DFlak/dingoPDM/DingoPDM/DingoPDM.kicad_pcb

## KiCad design DingoPDM/DingoPDM.kicad_pcb (2025-12-28)

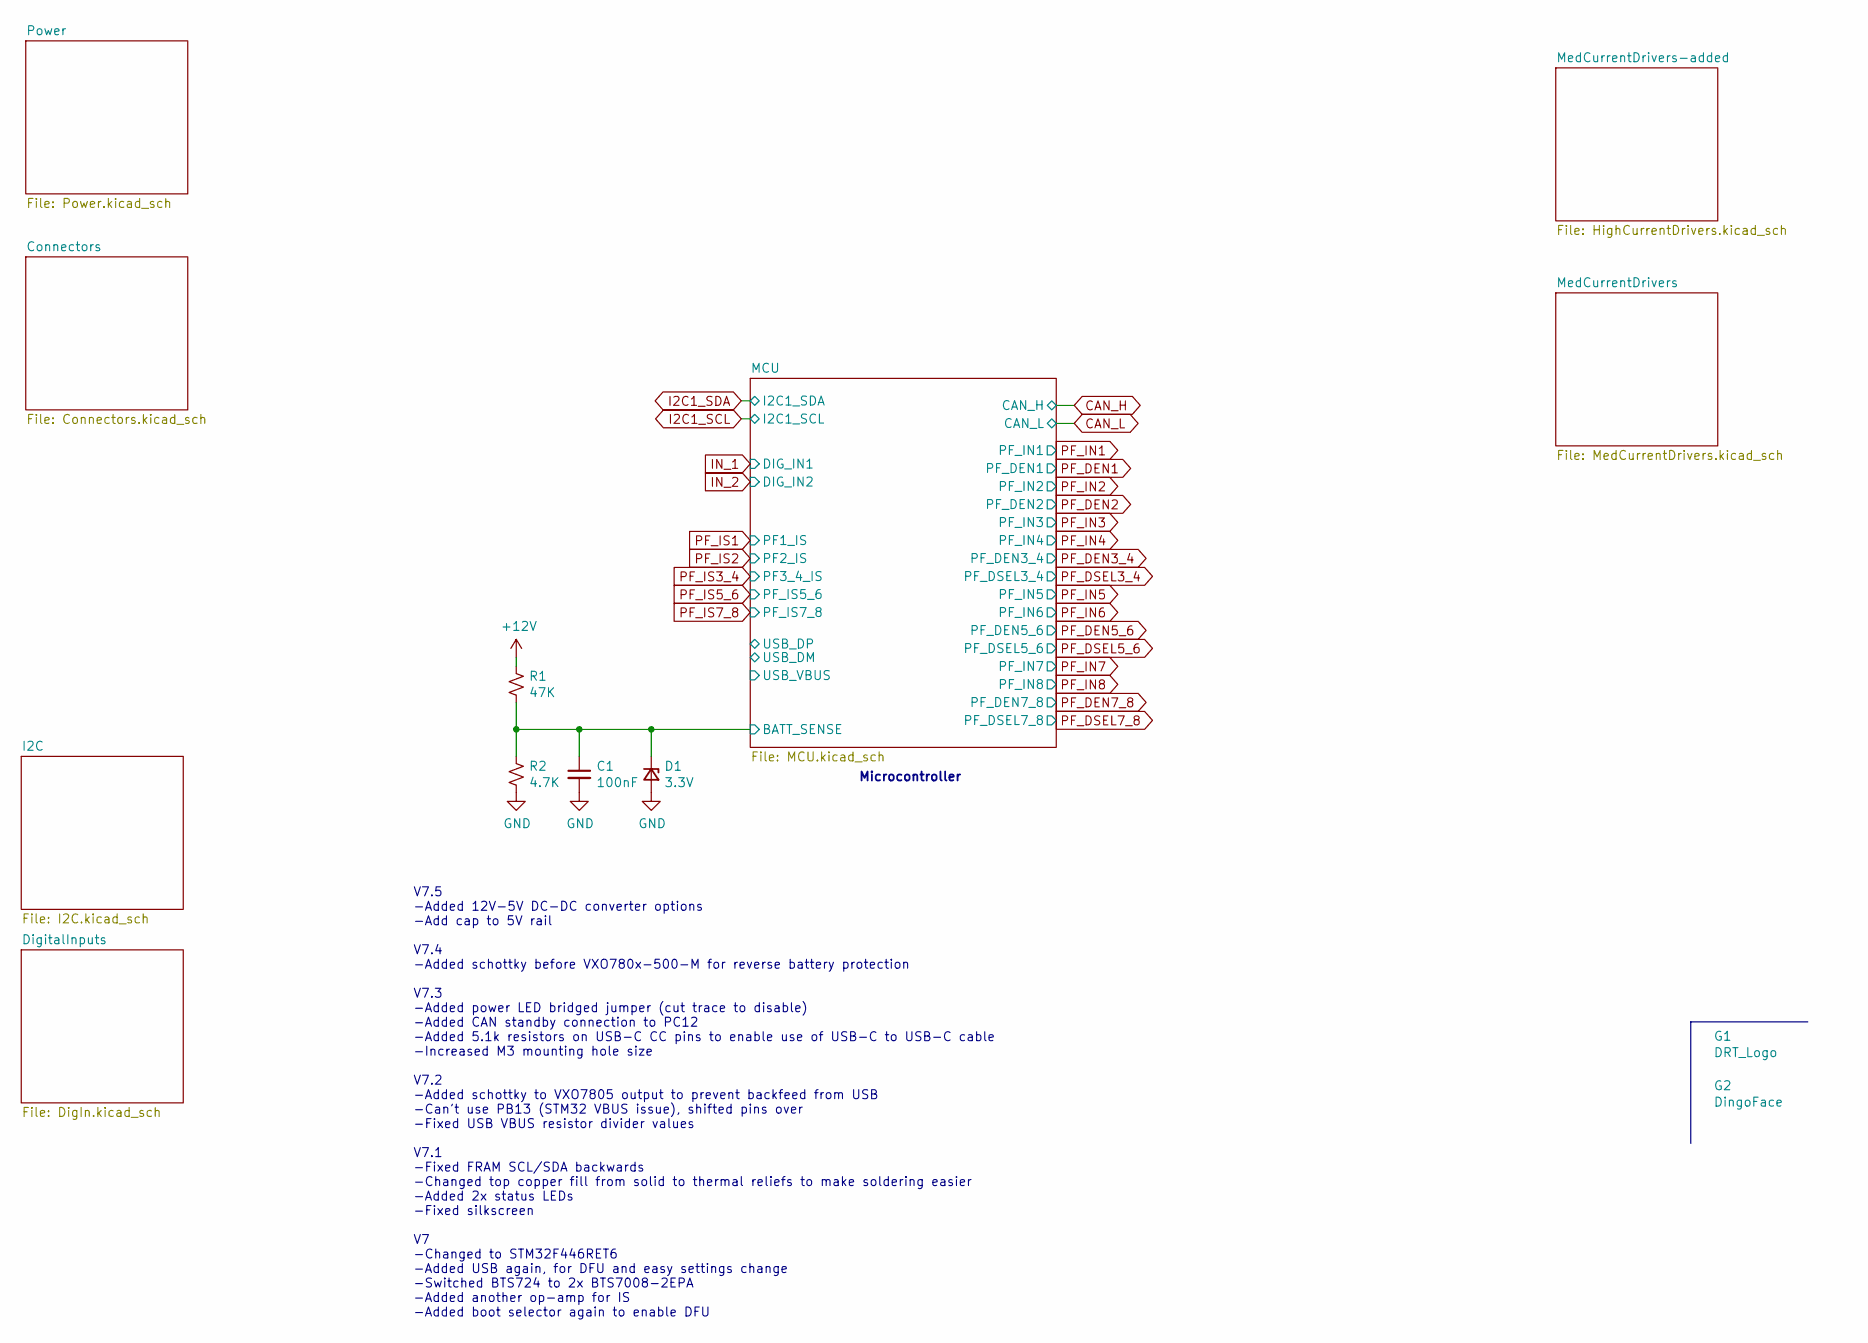
[picture p1: schematic DingoPDM.kicad_sch]

Parts:
C1: 100nF; C_0805_2012Metric; Digi-Key_PN 478-1395-1-ND
D1: 3.3V; D_SOD-323_HandSoldering; Digi-Key_PN 1727-5150-1-ND
G1: DRT_Logo; DRTLogo
G2: DingoFace; DingoFaceNoFill
R1: 47K; R_0805_2012Metric; Digi-Key_PN 311-47.0KCRCT-ND
R2: 4.7K; R_0805_2012Metric; Digi-Key_PN 311-4.70KCRCT-ND

Connections:
+12V: R1.1; also elsewhere on the board
/MCU/BATT_SENSE: C1.1, D1.1 (K), R1.2, R2.1; also elsewhere on the board
GND: C1.2, D1.2 (A), R2.2; also elsewhere on the board

Notes on the sheet:
Microcontroller
V7.5 -Added 12V-5V DC-DC converter options -Add cap to 5V rail V7.4 -Added schottky before VXO780x-500-M for reverse battery protection V7.3 -Added power LED bridged jumper (cut trace to disable) -Added CAN standby connection to PC12 -Added 5.1k resistors on USB-C CC pins to enable use of USB-C to 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

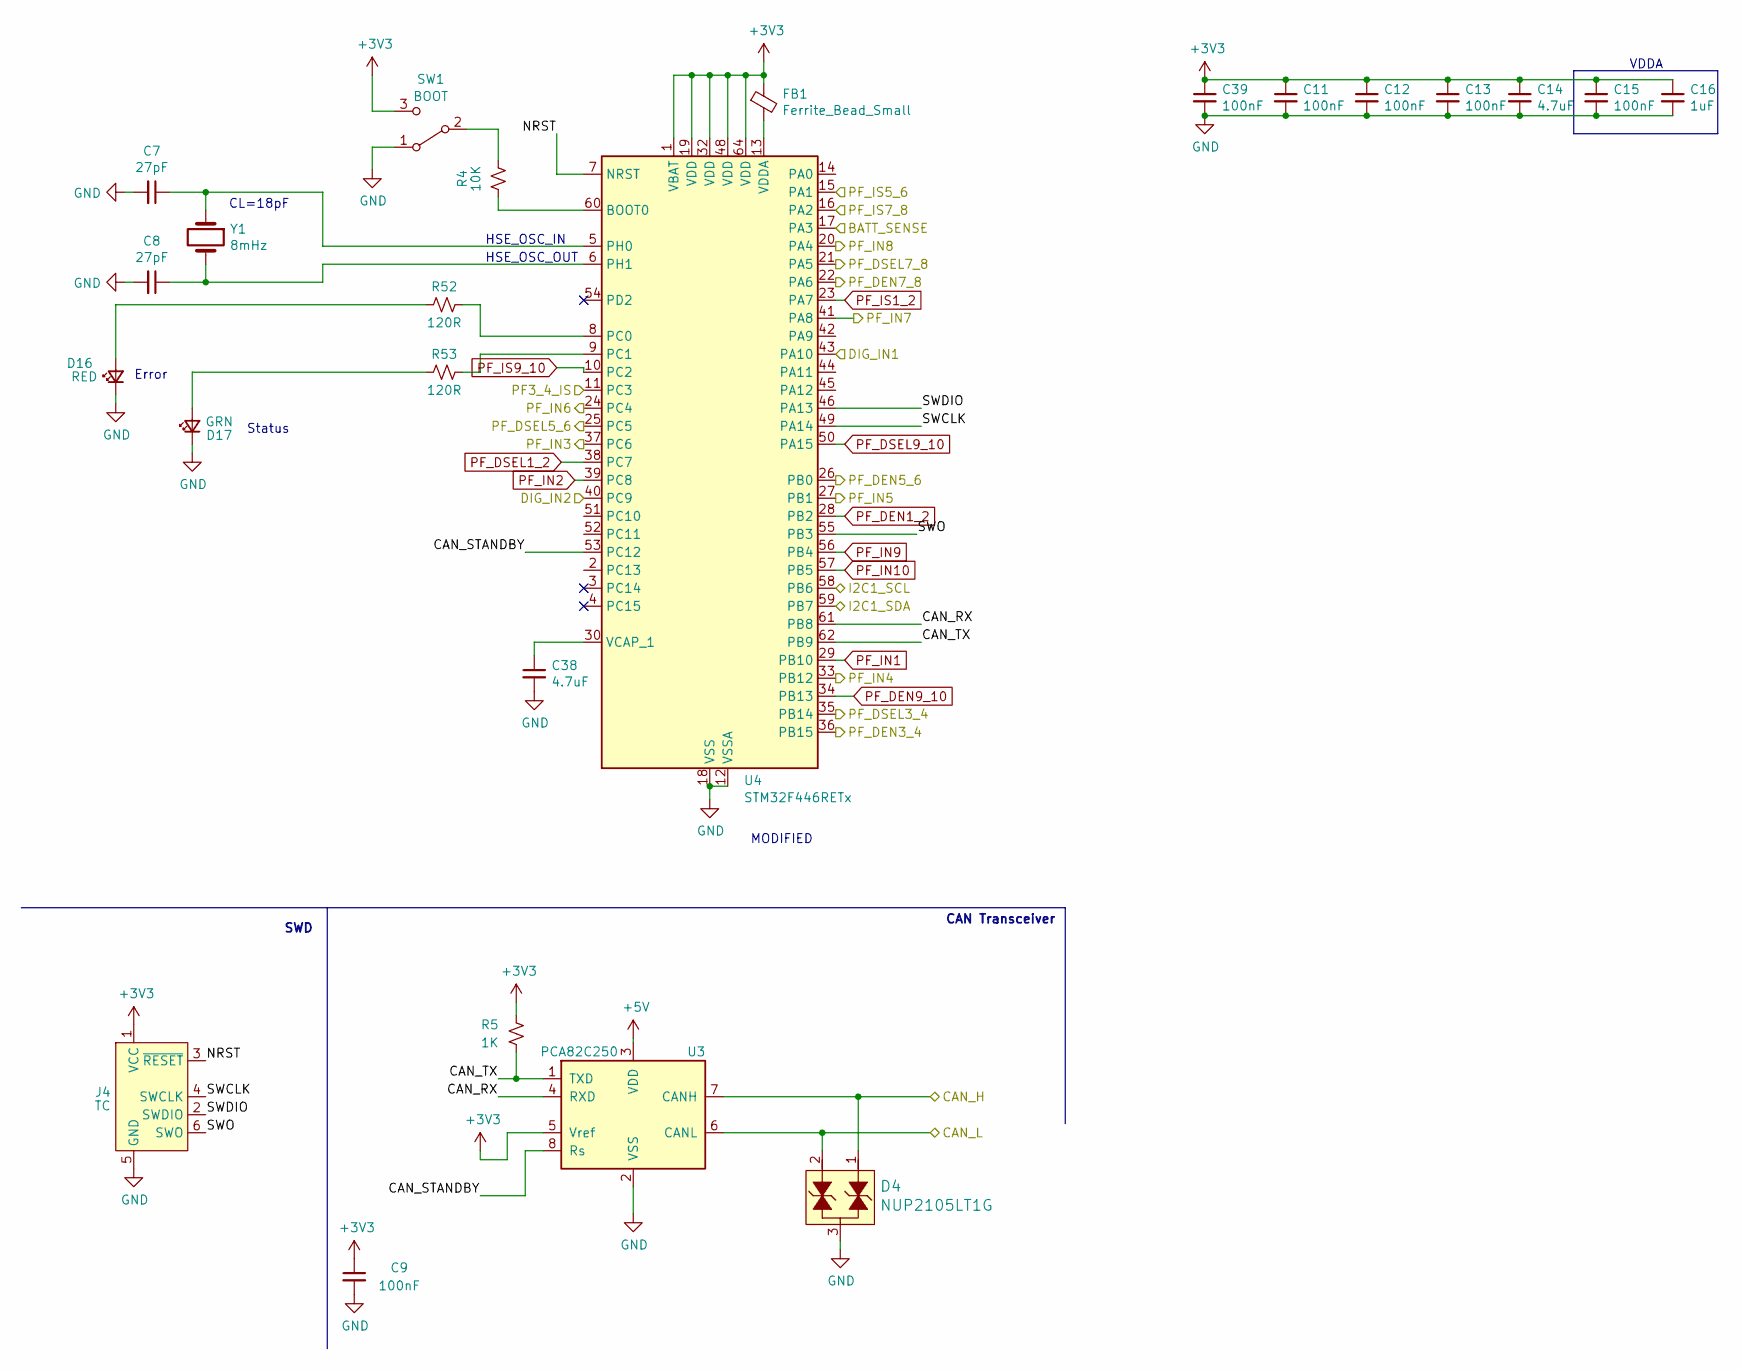
[picture p2: schematic MCU.kicad_sch, dingoPDM]

Parts:
C7, C8: 27pF; C_0805_2012Metric; Digi-Key_PN 478-10518-1-ND
C9, C11, C12, C13, C15, C39: 100nF; C_0805_2012Metric; Digi-Key_PN 478-1395-1-ND
C14, C38: 4.7uF; C_0805_2012Metric; Digi-Key_PN 1276-2873-1-ND
C16: 1uF; C_0805_2012Metric; Digi-Key_PN 311-1365-1-ND
D4: NUP2105LT1G; SOT-23-3; Digi-Key_PN NUP2105LT1GOSCT-ND
D16: RED; LED_0805_2012Metric; Digi-Key_PN 475-1278-1-ND
D17: GRN; LED_0805_2012Metric; Digi-Key_PN 475-1410-1-ND
FB1: Ferrite_Bead_Small; R_0805_2012Metric; Digi-Key_PN 490-1054-1-ND
J4: TC; Tag-Connect_TC2030-IDC-NL_2x03_P1.27mm_Vertical
R4: 10K; R_0805_2012Metric; Digi-Key_PN 311-10.0KCRDKR-ND
R5: 1K; R_0805_2012Metric; Digi-Key_PN 311-1.0KARCT-ND
R52, R53: 120R; R_0805_2012Metric; Digi-Key_PN 311-120CRCT-ND
SW1: BOOT; CJS-1200TB; Digi-Key_PN 563-CJS-1200TB1CT-ND
U3: PCA82C250; SOIC-8_3.9x4.9mm_P1.27mm; Digi-Key_PN 568-10316-1-ND
U4: STM32F446RETx; LQFP-64_10x10mm_P0.5mm; Digi-Key_PN 497-15376-ND
Y1: 8mHz; Crystal_SMD_5032-2Pin_5.0x3.2mm_HandSoldering; Digi-Key_PN 535-10630-1-ND

Connections:
+3V3: C9.1, C11.1, C12.1, C13.1, C14.1, C15.1, C16.1, C39.1, FB1.1, J4.1 (VCC), R5.2, SW1.3 (C), U3.5 (Vref), U4.1 (VBAT), U4.19 (VDD), U4.32 (VDD), U4.48 (VDD), U4.64 (VDD); also elsewhere on the board
+5V: U3.3 (VDD); also elsewhere on the board
/MCU/BATT_SENSE: U4.17 (PA3); also elsewhere on the board
/MCU/CAN_RX: U3.4 (RXD), U4.61 (PB8)
/MCU/CAN_STANDBY: U3.8 (Rs), U4.53 (PC12)
/MCU/CAN_TX: R5.1, U3.1 (TXD), U4.62 (PB9)
/MCU/NRST: J4.3 (~RESET), U4.7 (NRST)
/MCU/SWCLK: J4.4 (SWCLK), U4.49 (PA14)
/MCU/SWDIO: J4.2 (SWDIO), U4.46 (PA13)
/MCU/SWO: J4.6 (SWO), U4.55 (PB3)
CAN_H: D4.1, U3.7 (CANH); also elsewhere on the board
CAN_L: D4.2, U3.6 (CANL); also elsewhere on the board
GND: C7.2, C8.2, C9.2, C11.2, C12.2, C13.2, C14.2, C15.2, C16.2, C38.2, C39.2, D4.3, D16.1 (K), D17.1 (K), J4.5 (GND), SW1.1 (A), U3.2 (VSS), U4.12 (VSSA), U4.18 (VSS), U4.31 (VSS), U4.47 (VSS), U4.63 (VSS); also elsewhere on the board
I2C1_SCL: U4.58 (PB6); also elsewhere on the board
I2C1_SDA: U4.59 (PB7); also elsewhere on the board
IN_1: U4.43 (PA10); also elsewhere on the board
IN_2: U4.40 (PC9); also elsewhere on the board
unnamed: D16.2 (A), R52.2
unnamed: D17.2 (A), R53.2
unnamed: R4.1, SW1.2 (B)
unnamed: R4.2, U4.60 (BOOT0)
unnamed: R52.1, U4.8 (PC0)
unnamed: R53.1, U4.9 (PC1)
unnamed: C7.1, U4.5 (PH0), Y1.1
unnamed: C8.1, U4.6 (PH1), Y1.2
unnamed: C38.1, U4.30 (VCAP_1)
unnamed: FB1.2, U4.13 (VDDA)
PF_DEN1_2: U4.28 (PB2); also elsewhere on the board
PF_DEN3_4: U4.36 (PB15); also elsewhere on the board
PF_DEN5_6: U4.26 (PB0); also elsewhere on the board
PF_DEN7_8: U4.22 (PA6); also elsewhere on the board
PF_DEN9_10: U4.34 (PB13); also elsewhere on the board
PF_DSEL1_2: U4.38 (PC7); also elsewhere on the board
PF_DSEL3_4: U4.35 (PB14); also elsewhere on the board
PF_DSEL5_6: U4.25 (PC5); also elsewhere on the board
PF_DSEL7_8: U4.21 (PA5); also elsewhere on the board
PF_DSEL9_10: U4.50 (PA15); also elsewhere on the board
PF_IN1: U4.29 (PB10); also elsewhere on the board
PF_IN2: U4.39 (PC8); also elsewhere on the board
PF_IN3: U4.37 (PC6); also elsewhere on the board
PF_IN4: U4.33 (PB12); also elsewhere on the board
PF_IN5: U4.27 (PB1); also elsewhere on the board
PF_IN6: U4.24 (PC4); also elsewhere on the board
PF_IN7: U4.41 (PA8); also elsewhere on the board
PF_IN8: U4.20 (PA4); also elsewhere on the board
PF_IN9: U4.56 (PB4); also elsewhere on the board
PF_IN10: U4.57 (PB5); also elsewhere on the board
PF_IS1_2: U4.23 (PA7); also elsewhere on the board
PF_IS3_4: U4.11 (PC3); also elsewhere on the board
PF_IS5_6: U4.15 (PA1); also elsewhere on the board
PF_IS7_8: U4.16 (PA2); also elsewhere on the board
PF_IS9_10: U4.10 (PC2); also elsewhere on the board

Notes on the sheet:
SWD
Error
CAN Transceiver
HSE_OSC_IN
MODIFIED
CL=18pF
HSE_OSC_OUT
VDDA
Status

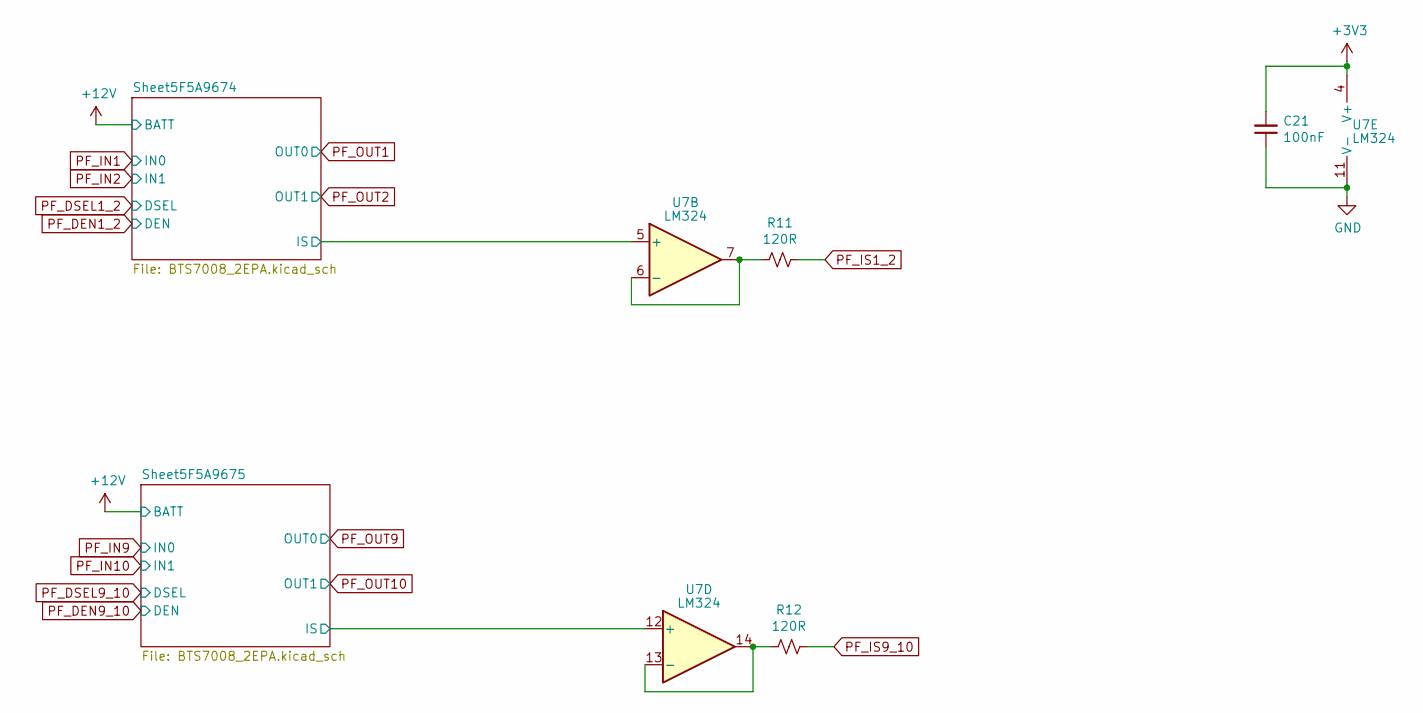
[picture p3: schematic HighCurrentDrivers.kicad_sch, dingoPDM]

Parts:
C21: 100nF; C_0805_2012Metric; Digi-Key_PN 478-1395-1-ND
R11, R12: 120R; R_0805_2012Metric; Digi-Key_PN 311-120CRCT-ND
U7: LM324; TSSOP-14_4.4x5mm_P0.65mm; Digi-Key_PN 497-7330-1-ND

Connections:
+3V3: C21.2, U7.4 (V+); also elsewhere on the board
/MedCurrentDrivers-added/Sheet5F5A9674/IS: U7.5 (+); also elsewhere on the board
/MedCurrentDrivers-added/Sheet5F5A9675/IS: U7.12 (+); also elsewhere on the board
/MedCurrentDrivers/Sheet5F5A9674/IS: U7.10 (+); also elsewhere on the board
GND: C21.1, U7.11 (V-); also elsewhere on the board
unnamed: R11.2, U7.6 (-), U7.7
unnamed 47: U7.8, U7.9 (-); also elsewhere on the board
unnamed: R12.2, U7.13 (-), U7.14
PF_IS1_2: R11.1; also elsewhere on the board
PF_IS9_10: R12.1; also elsewhere on the board

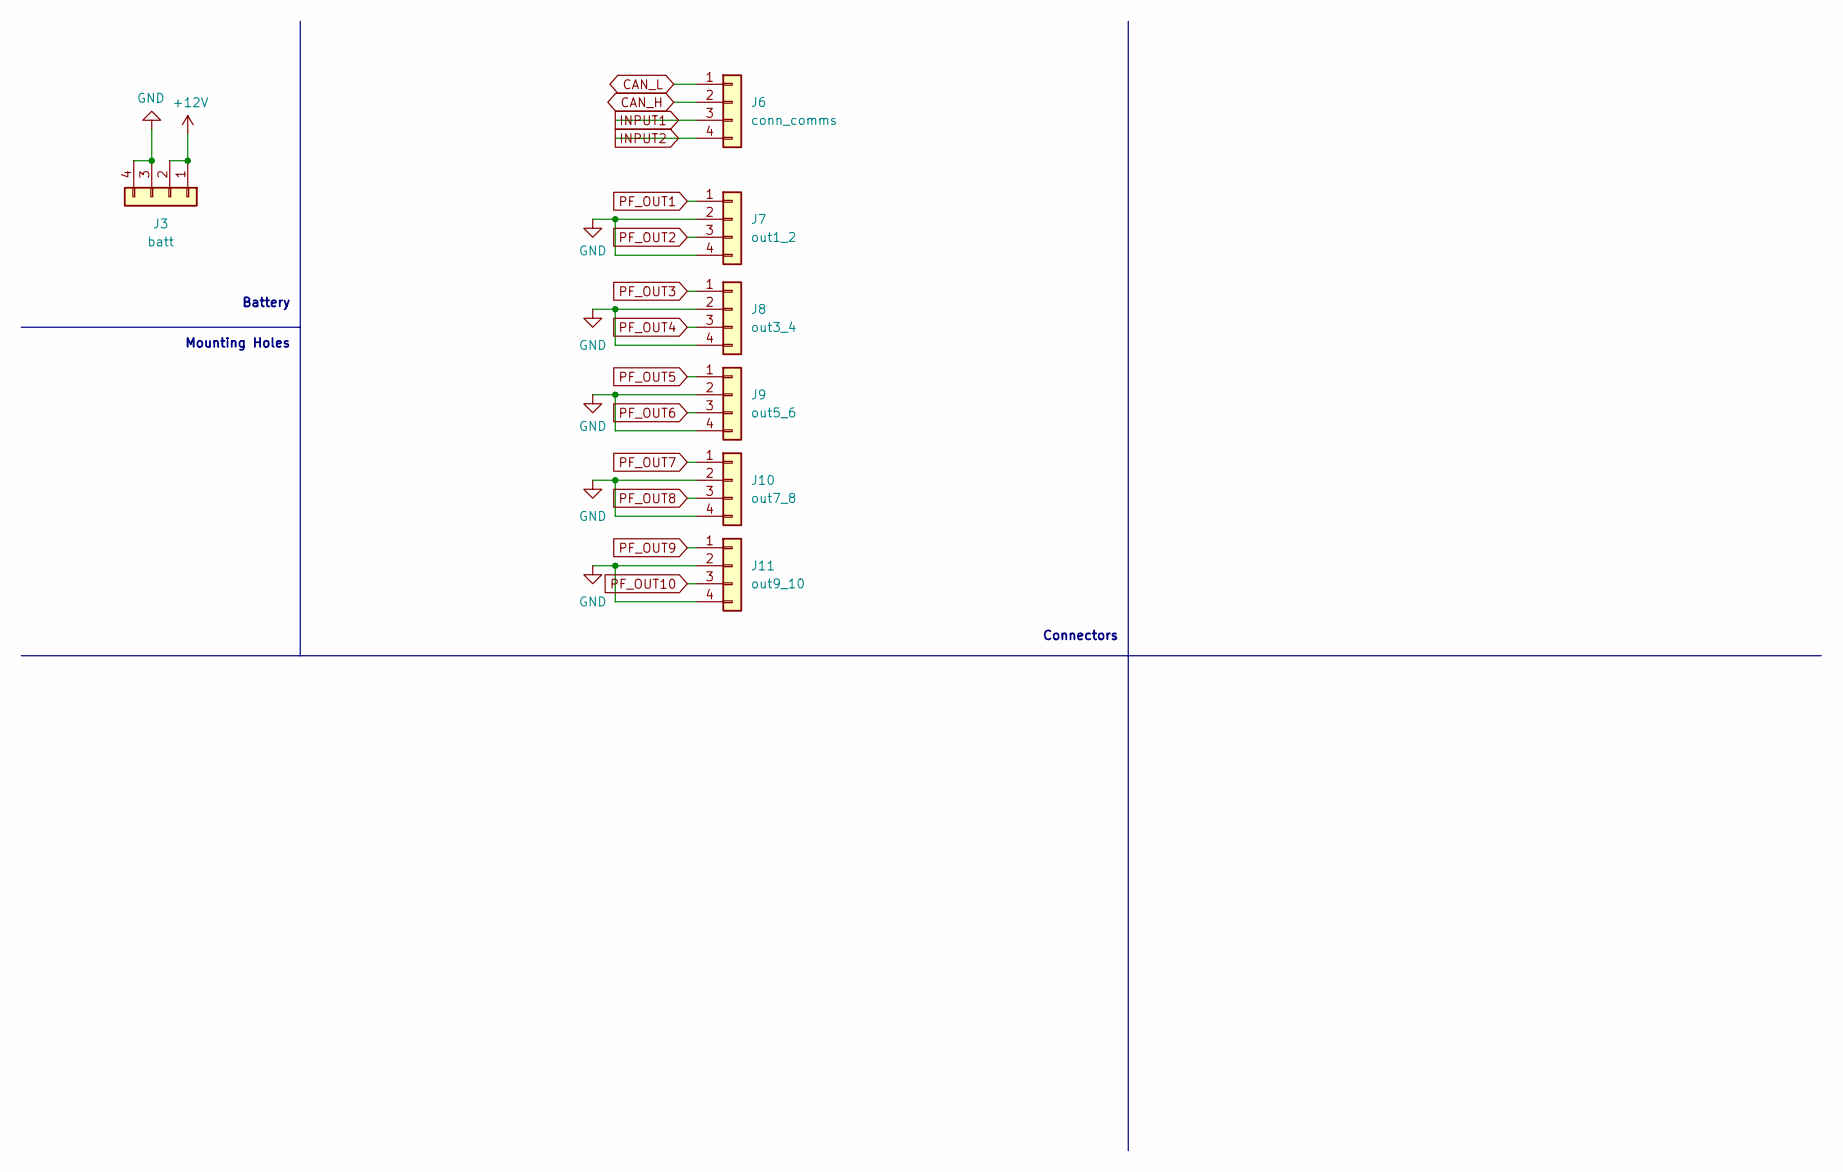
[picture p4: schematic Connectors.kicad_sch, dingoPDM]

Parts:
J3: batt; DIP-8_300_ELL
J6: conn_comms; DIP-8_300_ELL
J7: out1_2; DIP-8_300_ELL
J8: out3_4; DIP-8_300_ELL
J9: out5_6; DIP-8_300_ELL
J10: out7_8; DIP-8_300_ELL
J11: out9_10; DIP-8_300_ELL

Connections:
+12V: J3.1, J3.2; also elsewhere on the board
CAN_H: J6.2; also elsewhere on the board
CAN_L: J6.1; also elsewhere on the board
GND: J3.3, J3.4, J7.2, J7.4, J8.2, J8.4, J9.2, J9.4, J10.2, J10.4, J11.2, J11.4; also elsewhere on the board
INPUT1: J6.3; also elsewhere on the board
INPUT2: J6.4; also elsewhere on the board
PF_OUT1: J7.1; also elsewhere on the board
PF_OUT2: J7.3; also elsewhere on the board
PF_OUT3: J8.1; also elsewhere on the board
PF_OUT4: J8.3; also elsewhere on the board
PF_OUT5: J9.1; also elsewhere on the board
PF_OUT6: J9.3; also elsewhere on the board
PF_OUT7: J10.1; also elsewhere on the board
PF_OUT8: J10.3; also elsewhere on the board
PF_OUT9: J11.1; also elsewhere on the board
PF_OUT10: J11.3; also elsewhere on the board

Notes on the sheet:
Connectors
Battery
Mounting Holes

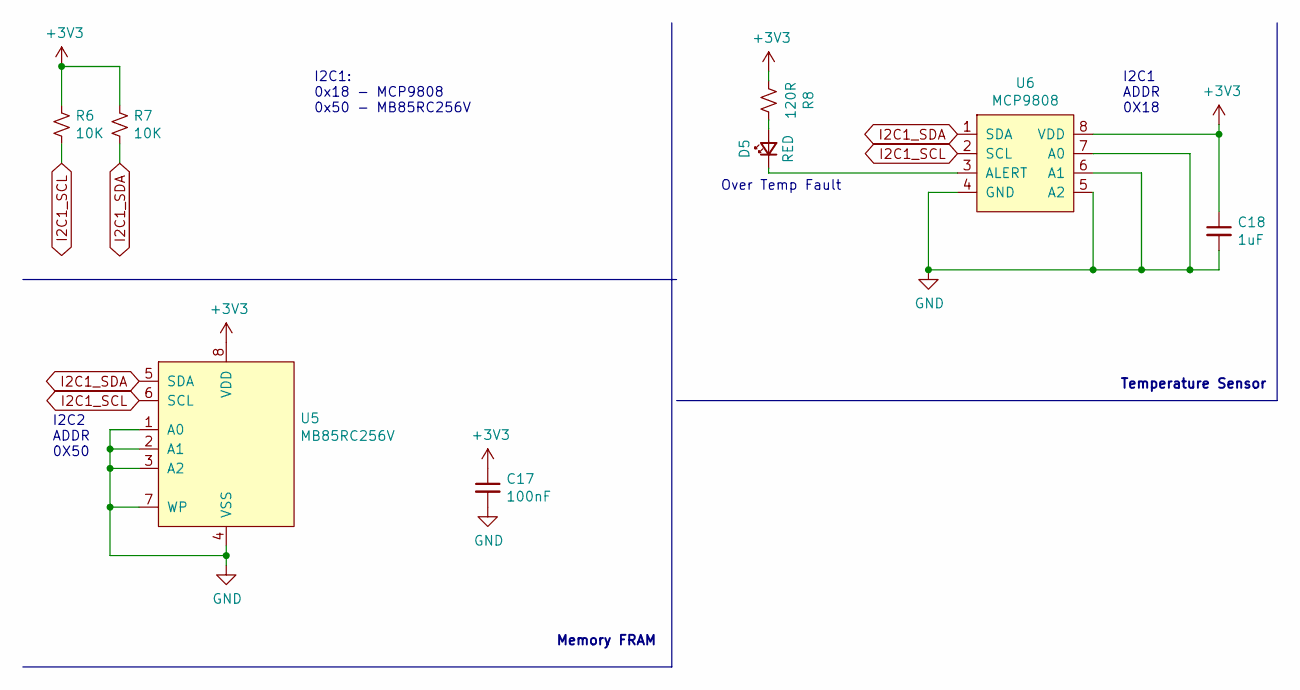
[picture p5: schematic I2C.kicad_sch, dingoPDM]

Parts:
C17: 100nF; C_0805_2012Metric; Digi-Key_PN 478-1395-1-ND
C18: 1uF; C_0805_2012Metric; Digi-Key_PN 311-1365-1-ND
D5: RED; LED_0805_2012Metric; Digi-Key_PN 475-1278-1-ND
R6, R7: 10K; R_0805_2012Metric; Digi-Key_PN 311-10.0KCRDKR-ND
R8: 120R; R_0805_2012Metric; Digi-Key_PN 311-120CRCT-ND
U5: MB85RC256V; SOIC-8_3.9x4.9mm_P1.27mm; Digi-Key_PN 865-1261-1-ND
U6: MCP9808; MSOP-8_3x3mm_P0.65mm; Digi-Key_PN MCP9808T-E/MSCT-ND

Connections:
+3V3: C17.1, C18.1, R6.1, R7.1, R8.2, U5.8 (VDD), U6.8 (VDD); also elsewhere on the board
GND: C17.2, C18.2, U5.1 (A0), U5.2 (A1), U5.3 (A2), U5.4 (VSS), U5.7 (WP), U6.4 (GND), U6.5 (A2), U6.6 (A1), U6.7 (A0); also elsewhere on the board
I2C1_SCL: R6.2, U5.6 (SCL), U6.2 (SCL); also elsewhere on the board
I2C1_SDA: R7.2, U5.5 (SDA), U6.1 (SDA); also elsewhere on the board
unnamed: D5.2 (A), R8.1
unnamed: D5.1 (K), U6.3 (ALERT)

Notes on the sheet:
I2C1 ADDR 0X18
I2C2 ADDR 0X50
Over Temp Fault
Temperature Sensor
I2C1: 0x18 - MCP9808 0x50 - MB85RC256V
Memory FRAM

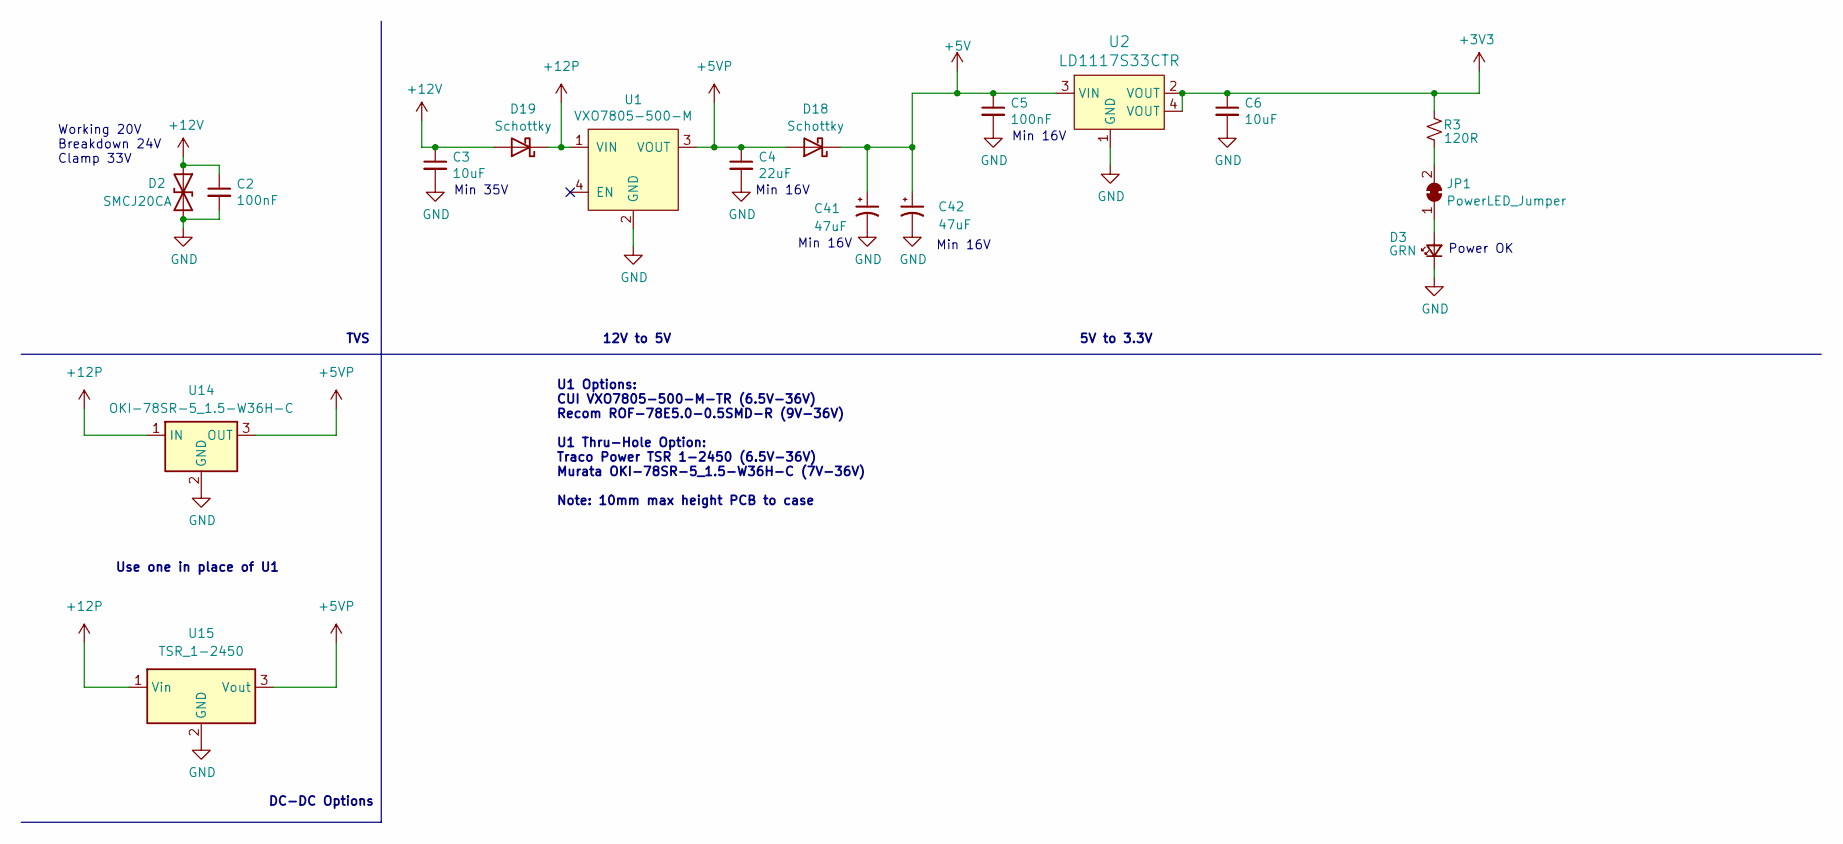
[picture p6: schematic Power.kicad_sch, dingoPDM]

Parts:
C2, C5: 100nF; C_0805_2012Metric; Digi-Key_PN 478-1395-1-ND
C3, C6: 10uF; C_0805_2012Metric; Digi-Key_PN 445-11516-1-ND
C4: 22uF; C_0805_2012Metric; Digi-Key_PN 490-10749-1-ND
C41, C42: 47uF; C_2220_5750Metric; Digi-Key_PN 445-7935-1-ND
D2: SMCJ20CA; DO-214AB_TVS; Digi-Key_PN SMCJ20CABCT-ND
D3: GRN; LED_0805_2012Metric; Digi-Key_PN 475-1410-1-ND
D18, D19: Schottky; D_SOD-123; Digi-Key_PN 1727-2394-1-ND
JP1: PowerLED_Jumper; SolderJumper-2_P1.3mm_Bridged_RoundedPad1.0x1.5mm
R3: 120R; R_0805_2012Metric; Digi-Key_PN 311-120CRCT-ND
U1: VXO7805-500-M; VXO78x-500-M; Digi-Key_PN 102-VXO7805-500-M-CT-ND
U2: LD1117S33CTR; SOT-223; Digi-Key_PN 497-1241-1-ND
U14: OKI-78SR-5_1.5-W36H-C; Converter_DCDC_Murata_OKI-78SR_Horizontal
U15: TSR_1-2450; Converter_DCDC_TRACO_TSR-1_THT

Connections:
+3V3: C6.1, R3.2, U2.2 (VOUT), U2.4 (VOUT); also elsewhere on the board
+5V: C5.1, C41.1, C42.1, D18.1 (K), U2.3 (VIN); also elsewhere on the board
+5VP: C4.1, D18.2 (A), U1.3 (VOUT), U14.3 (OUT), U15.3 (Vout)
+12P: D19.1 (K), U1.1 (VIN), U14.1 (IN), U15.1 (Vin)
+12V: C2.1, C3.1, D2.1 (A1), D19.2 (A); also elsewhere on the board
GND: C2.2, C3.2, C4.2, C5.2, C6.2, C41.2, C42.2, D2.2 (A2), D3.1 (K), U1.2 (GND), U2.1 (GND), U14.2 (GND), U15.2 (GND); also elsewhere on the board
unnamed: D3.2 (A), JP1.1 (A)
unnamed: JP1.2 (B), R3.1

Notes on the sheet:
Min 16V
TVS
Min 35V
Power OK
5V to 3.3V
U1 Options: CUI VXO7805-500-M-TR (6.5V-36V) Recom ROF-78E5.0-0.5SMD-R (9V-36V) U1 Thru-Hole Option: Traco Power TSR 1-2450 (6.5V-36V) Murata OKI-78SR-5_1.5-W36H-C (7V-36V) Note: 10mm max height PCB to case
12V to 5V
DC-DC Options
Use one in place of U1
Working 20V Breakdown 24V Clamp 33V

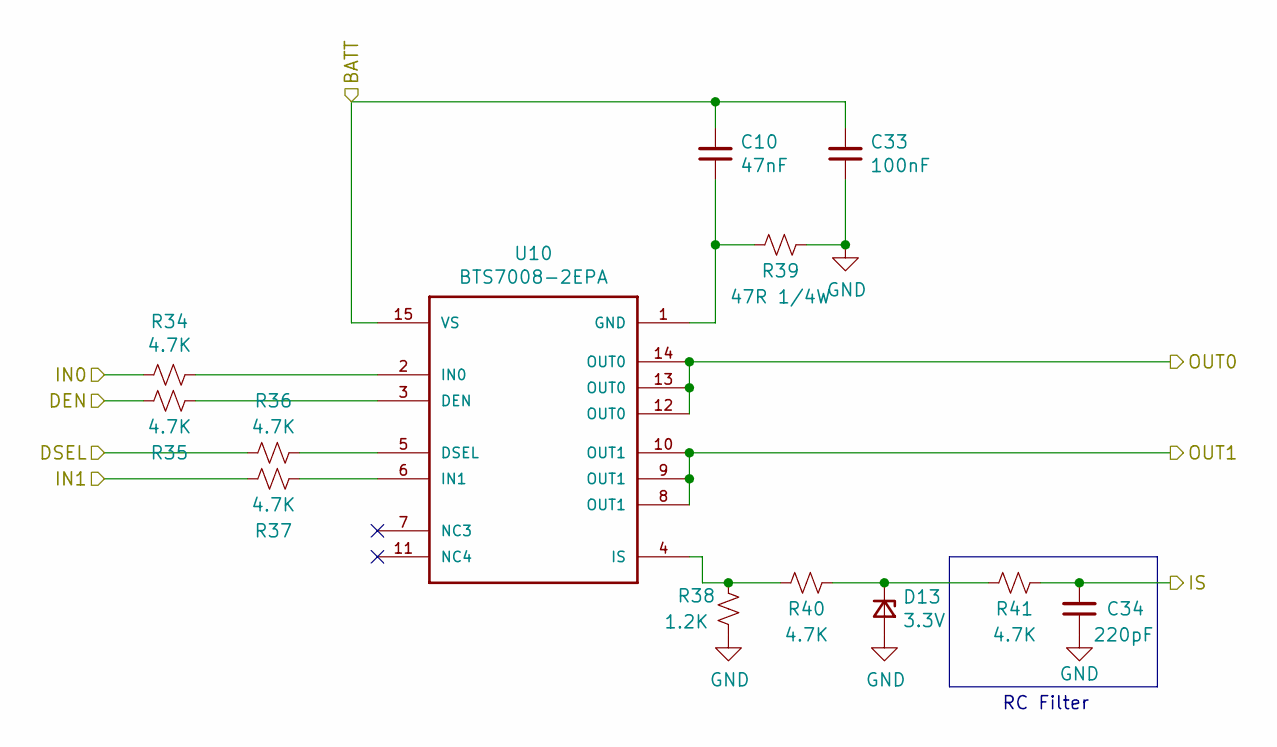
[picture p7: schematic BTS7008_2EPA.kicad_sch, dingoPDM]

Parts:
C10: 47nF; C_0805_2012Metric; Digi-Key_PN 399-1166-1-ND
C33: 100nF; C_0805_2012Metric; Digi-Key_PN 478-1395-1-ND
C34: 220pF; C_0805_2012Metric; Digi-Key_PN 399-1138-1-ND
D13: 3.3V; D_SOD-323_HandSoldering; Digi-Key_PN 1727-5150-1-ND
R34, R35, R36, R37, R40, R41: 4.7K; R_0805_2012Metric; Digi-Key_PN 311-4.70KCRCT-ND
R38: 1.2K; R_0805_2012Metric; Digi-Key_PN 311-1.20KCRCT-ND
R39: 47R 1/4W; R_1206_3216Metric; Digi-Key_PN 311-47.0FRCT-ND
U10: BTS7008-2EPA; TDSO-14; Digi-Key_PN BTS70082EPAXUMA1CT-ND

Connections:
+12V: C10.2, C33.2, U10.15 (VS); also elsewhere on the board
/MedCurrentDrivers/Sheet5F5A9675/IS: C34.2, R41.1; also elsewhere on the board
GND: C33.1, C34.1, D13.2 (A), R38.2, R39.1; also elsewhere on the board
unnamed: D13.1 (K), R40.1, R41.2
unnamed: R35.1, U10.3 (DEN)
unnamed: R36.2, U10.5 (DSEL)
unnamed: C10.1, R39.2, U10.1 (GND)
unnamed: R34.1, U10.2 (IN0)
unnamed: R37.1, U10.6 (IN1)
unnamed: R38.1, R40.2, U10.4 (IS)
PF_DEN5_6: R35.2; also elsewhere on the board
PF_DSEL5_6: R36.1; also elsewhere on the board
PF_IN5: R34.2; also elsewhere on the board
PF_IN6: R37.2; also elsewhere on the board
PF_OUT5: U10.12 (OUT0), U10.13 (OUT0), U10.14 (OUT0); also elsewhere on the board
PF_OUT6: U10.8 (OUT1), U10.9 (OUT1), U10.10 (OUT1); also elsewhere on the board

Parts of its further copies:
C22, C25, C30, C35: 47nF; C_0805_2012Metric; Digi-Key_PN 399-1166-1-ND
C23, C26, C31, C36: 100nF; C_0805_2012Metric; Digi-Key_PN 478-1395-1-ND
C24, C27, C32, C37: 220pF; C_0805_2012Metric; Digi-Key_PN 399-1138-1-ND
D8, D9, D12, D14: 3.3V; D_SOD-323_HandSoldering; Digi-Key_PN 1727-5150-1-ND
R13, R14, R15, R16, R17, R20, R21, R22, R23, R24, R26, R27, R28, R29, R32, R33, R43, R44, R45, R46, R49, R50, R60, R61: 4.7K; R_0805_2012Metric; Digi-Key_PN 311-4.70KCRCT-ND
R18, R30, R47, R58: 1.2K; R_0805_2012Metric; Digi-Key_PN 311-1.20KCRCT-ND
R19, R31, R48, R59: 47R 1/4W; R_1206_3216Metric; Digi-Key_PN 311-47.0FRCT-ND
U8, U9, U11, U13: BTS7008-2EPA; TDSO-14; Digi-Key_PN BTS70082EPAXUMA1CT-ND

Connections of its further copies:
+12V: C22.2, C23.2, C25.2, C26.2, C30.2, C31.2, C35.2, C36.2, U8.15 (VS), U9.15 (VS), U11.15 (VS), U13.15 (VS); also elsewhere on the board
/MedCurrentDrivers-added/Sheet5F5A9674/IS: C24.2, R21.1; also elsewhere on the board
/MedCurrentDrivers-added/Sheet5F5A9675/IS: C27.2, R61.1; also elsewhere on the board
/MedCurrentDrivers/Sheet5F5A9674/IS: C32.2, R33.1; also elsewhere on the board
/MedCurrentDrivers/Sheet5F5A9676/IS: C37.2, R50.1; also elsewhere on the board
GND: C23.1, C24.1, C26.1, C27.1, C31.1, C32.1, C36.1, C37.1, D8.2 (A), D9.2 (A), D12.2 (A), D14.2 (A), R18.2, R19.1, R30.2, R31.1, R47.2, R48.1, R58.2, R59.1; also elsewhere on the board
unnamed: D8.1 (K), R20.1, R21.2
unnamed: D9.1 (K), R60.1, R61.2
unnamed: D12.1 (K), R32.1, R33.2
unnamed: D14.1 (K), R49.1, R50.2
unnamed: R22.1, U8.3 (DEN)
unnamed: R23.2, U8.5 (DSEL)
unnamed: C25.1, R59.2, U8.1 (GND)
unnamed: R13.1, U8.2 (IN0)
unnamed: R24.1, U8.6 (IN1)
unnamed: R58.1, R60.2, U8.4 (IS)
unnamed: R15.1, U9.3 (DEN)
unnamed: R16.2, U9.5 (DSEL)
unnamed: C22.1, R19.2, U9.1 (GND)
unnamed: R14.1, U9.2 (IN0)
unnamed: R17.1, U9.6 (IN1)
unnamed: R18.1, R20.2, U9.4 (IS)
unnamed: R27.1, U11.3 (DEN)
unnamed: R28.2, U11.5 (DSEL)
unnamed: C30.1, R31.2, U11.1 (GND)
unnamed: R26.1, U11.2 (IN0)
unnamed: R29.1, U11.6 (IN1)
unnamed: R30.1, R32.2, U11.4 (IS)
unnamed: R44.1, U13.3 (DEN)
unnamed: R45.2, U13.5 (DSEL)
unnamed: C35.1, R48.2, U13.1 (GND)
unnamed: R43.1, U13.2 (IN0)
unnamed: R46.1, U13.6 (IN1)
unnamed: R47.1, R49.2, U13.4 (IS)
PF_DEN1_2: R15.2; also elsewhere on the board
PF_DEN3_4: R27.2; also elsewhere on the board
PF_DEN7_8: R44.2; also elsewhere on the board
PF_DEN9_10: R22.2; also elsewhere on the board
PF_DSEL1_2: R16.1; also elsewhere on the board
PF_DSEL3_4: R28.1; also elsewhere on the board
PF_DSEL7_8: R45.1; also elsewhere on the board
PF_DSEL9_10: R23.1; also elsewhere on the board
PF_IN1: R14.2; also elsewhere on the board
PF_IN2: R17.2; also elsewhere on the board
PF_IN3: R26.2; also elsewhere on the board
PF_IN4: R29.2; also elsewhere on the board
PF_IN7: R43.2; also elsewhere on the board
PF_IN8: R46.2; also elsewhere on the board
PF_IN9: R13.2; also elsewhere on the board
PF_IN10: R24.2; also elsewhere on the board
PF_OUT1: U9.12 (OUT0), U9.13 (OUT0), U9.14 (OUT0); also elsewhere on the board
PF_OUT2: U9.8 (OUT1), U9.9 (OUT1), U9.10 (OUT1); also elsewhere on the board
PF_OUT3: U11.12 (OUT0), U11.13 (OUT0), U11.14 (OUT0); also elsewhere on the board
PF_OUT4: U11.8 (OUT1), U11.9 (OUT1), U11.10 (OUT1); also elsewhere on the board
PF_OUT7: U13.12 (OUT0), U13.13 (OUT0), U13.14 (OUT0); also elsewhere on the board
PF_OUT8: U13.8 (OUT1), U13.9 (OUT1), U13.10 (OUT1); also elsewhere on the board
PF_OUT9: U8.12 (OUT0), U8.13 (OUT0), U8.14 (OUT0); also elsewhere on the board
PF_OUT10: U8.8 (OUT1), U8.9 (OUT1), U8.10 (OUT1); also elsewhere on the board

Notes on the sheet:
RC Filter

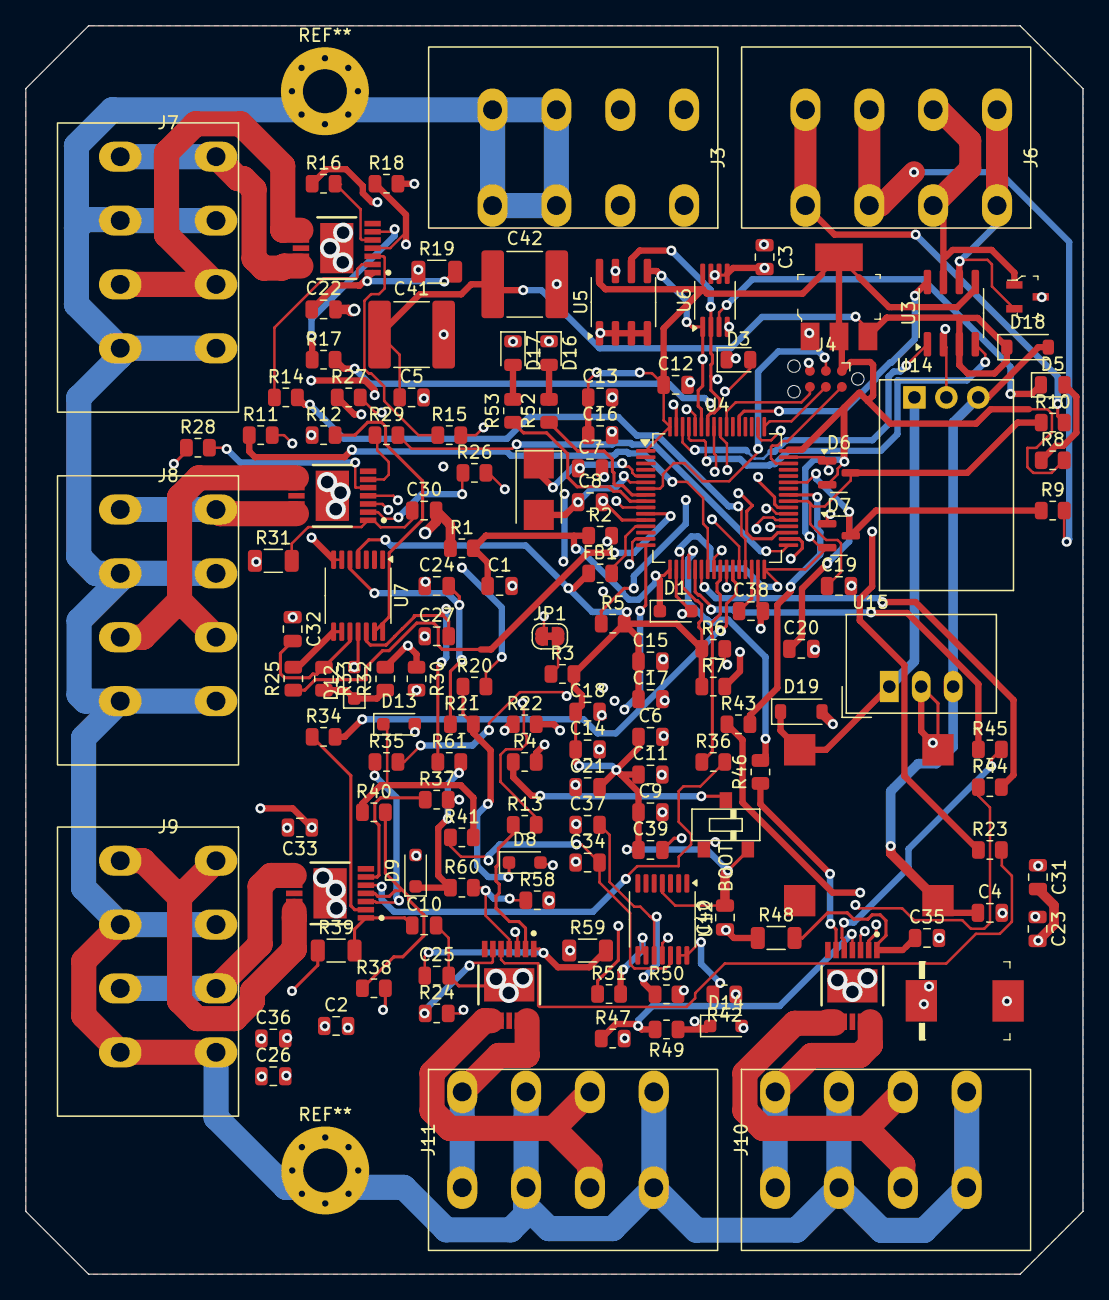
[picture p8: board DingoPDM.kicad_pcb from above]

Board: 4 copper layers, 84.1 x 99.3 mm, 140 parts (0 on the bottom side), 116 nets.

Other parts of the board:
C19, C20: 10nF; C_0805_2012Metric
C40: 100nF; C_0805_2012Metric
D6, D7: BAT54S; SOT-23
R9, R10: 4.7K; R_0805_2012Metric
R25, R42, R51: 120R; R_0805_2012Metric
U12: LM324; TSSOP-14_4.4x5mm_P0.65mm

Their connections:
+3V3: C40.2, D6.2, D7.2, U12.4 (V+); also elsewhere on the board
/MedCurrentDrivers/Sheet5F5A9675/IS: U12.12 (+); also elsewhere on the board
/MedCurrentDrivers/Sheet5F5A9676/IS: U12.10 (+); also elsewhere on the board
GND: C19.2, C20.2, C40.1, D6.1, D7.1, U12.11 (V-); also elsewhere on the board
INPUT1: R9.2; also elsewhere on the board
INPUT2: R10.2; also elsewhere on the board
IN_1: C20.1, D7.3, R9.1; also elsewhere on the board
IN_2: C19.1, D6.3, R10.1; also elsewhere on the board
unnamed 47: R25.2; also elsewhere on the board
unnamed: R51.2, U12.8, U12.9 (-)
unnamed: R42.2, U12.13 (-), U12.14
PF_IS3_4: R25.1; also elsewhere on the board
PF_IS5_6: R42.1; also elsewhere on the board
PF_IS7_8: R51.1; also elsewhere on the board
